enveloop/miniMO/README.md

# miniMO
Programmable mini Synthesizer Module </br>

https://minimosynth.com/

we've got a forum! 

https://www.minimosynth.com/forum/
