enveloop/miniMO/BOM_and_schematic/miniMO_schematic.png

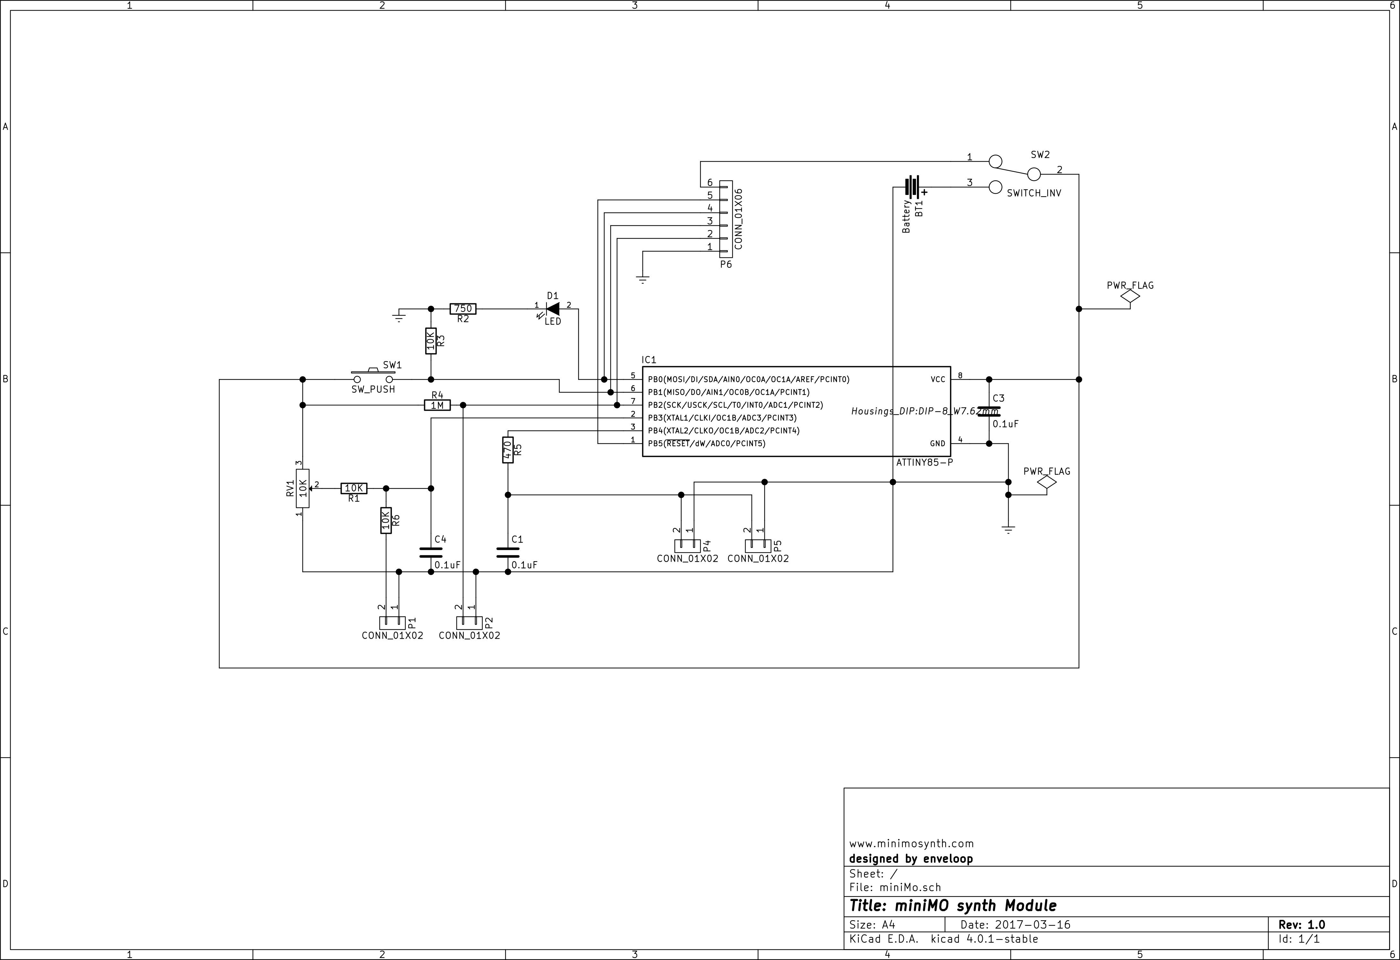
BOM_and_schematic/miniMO_schematic.png
