enveloop/miniMO/3D_parts/3Dprinted_model/parts_description.txt

3D Printed Model

	/Structure

		In order of assembly (bottom to top):
 		
		*battery_holder
		*battery_lid
		*breadboard_holder
		*breadboard
		*ports_holder
		*top
		*shaft neck
		
		Settings: 
			All parts Rigid filament (PLA), layer height 0.3 mm, default speed 40 mm/s
			Head diameter 0.40 EXCEPT for the breadboard, which needs a 0.25 or less
			
	/Covers

		*down_cover
		*up_cover

			Settings: same as above
