enveloop/miniMO/3D_parts/3Dprinted_model/miniMO_3Dprint.jpg

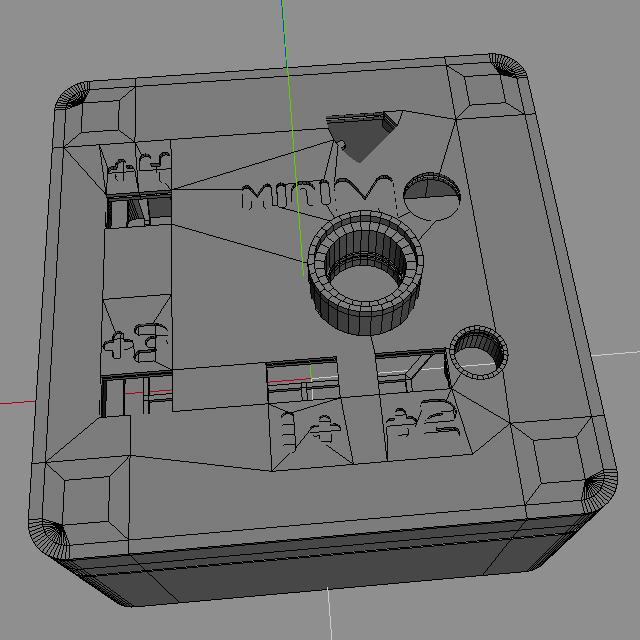
3D_parts/3Dprinted_model/miniMO_3Dprint.jpg
