enveloop/miniMO/3D_parts/3Dprinted_model/miniMO_3Dprint_exploded.jpg

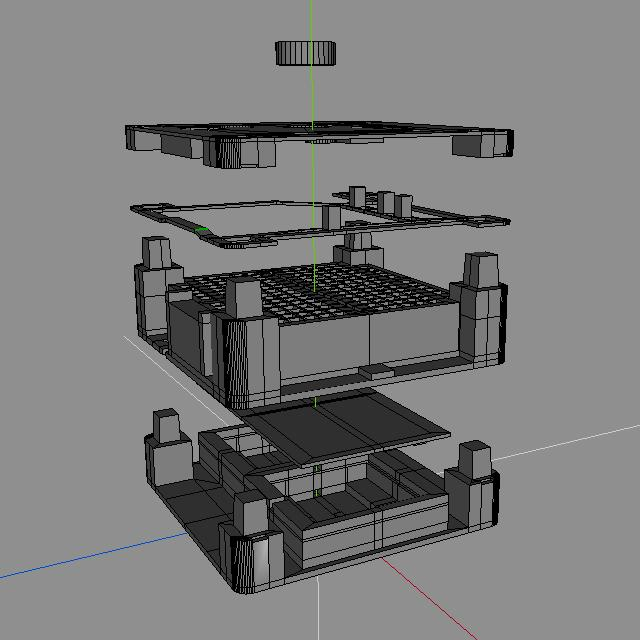
3D_parts/3Dprinted_model/miniMO_3Dprint_exploded.jpg
