enveloop/miniMO/BOM_and_schematic/Gerber_panel_2x2/minimo_Combined_Bottom.png

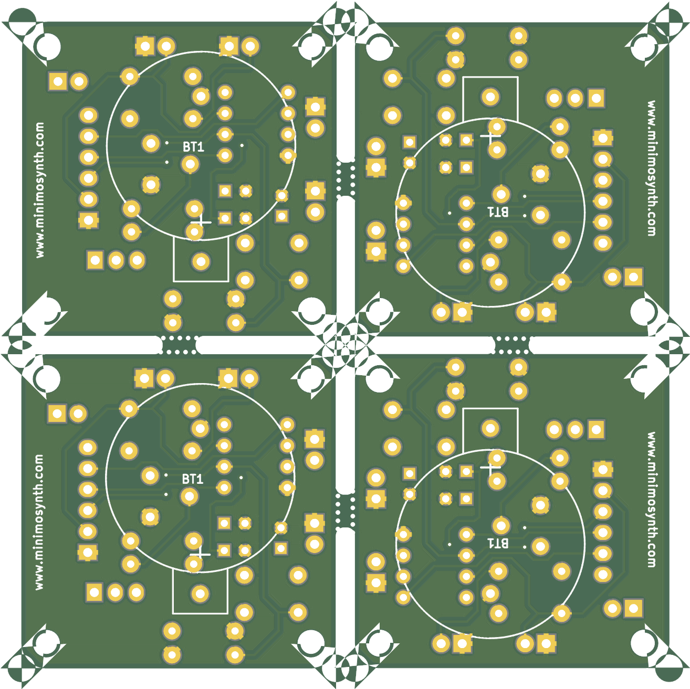
BOM_and_schematic/Gerber_panel_2x2/minimo_Combined_Bottom.png
