enveloop/miniMO/3D_parts/3Dprinted_model/Covers/down_cover.stl

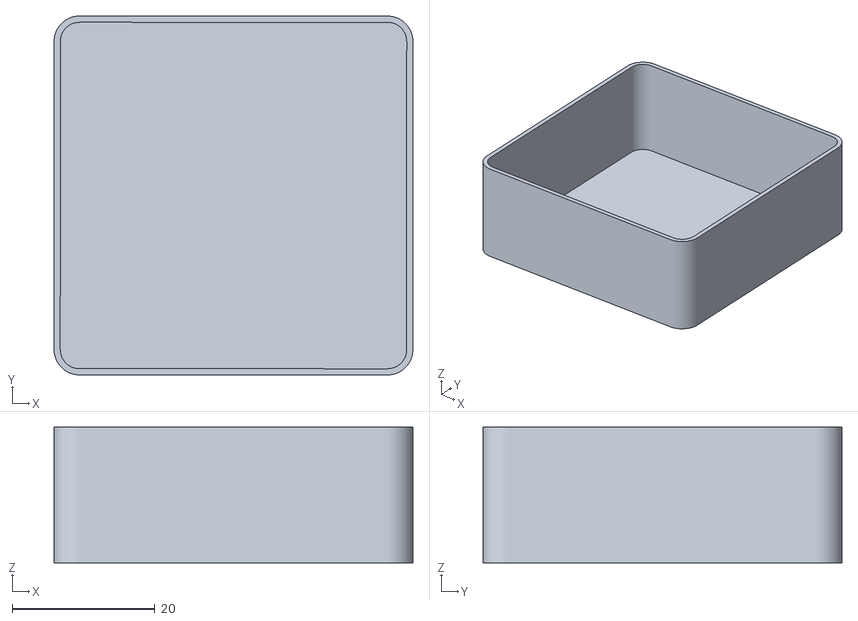
[picture p6: CAD file, 2017-03-13]
3D_parts/3Dprinted_model/Covers/down_cover.stl
50.3 x 50.3 x 19.0
