enveloop/miniMO/3D_parts/PCB_model/Case/Bases/for_flexible_cover/2_part_case_up_base_for_flexible_cover.stl

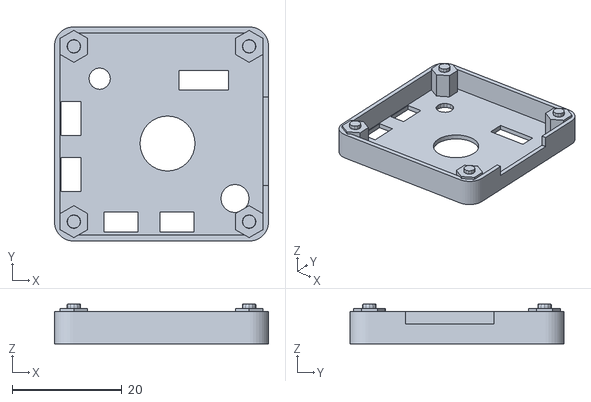
[picture p8: CAD file, 2016-07-05]
3D_parts/PCB_model/Case/Bases/for_flexible_cover/2_part_case_up_base_for_flexible_cover.stl
38.9 x 39.0 x 7.20
