enveloop/miniMO/3D_parts/PCB_model/Case/Bases/for_rigid_cover/2_part_case_up_base.stl

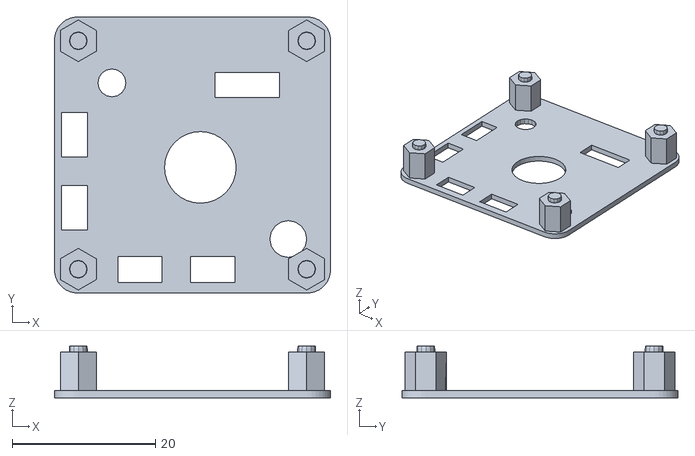
[picture p9: CAD file, 2016-07-05]
3D_parts/PCB_model/Case/Bases/for_rigid_cover/2_part_case_up_base.stl
38.6 x 38.6 x 7.20
