enveloop/miniMO/3D_parts/PCB_model/Case/Covers/2_part_case_up_cover.stl

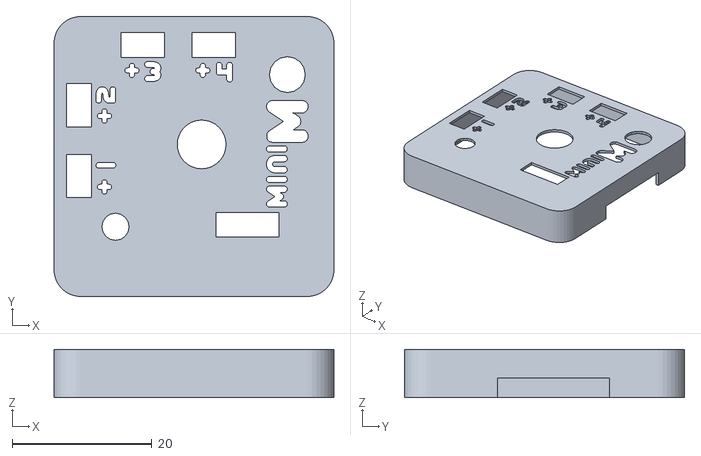
[picture p10: CAD file, 2016-07-05]
3D_parts/PCB_model/Case/Covers/2_part_case_up_cover.stl
40.1 x 40.1 x 6.90
