enveloop/miniMO/3D_parts/PCB_model/Connectors_and_Legs/hex_legs_stabilizer.stl

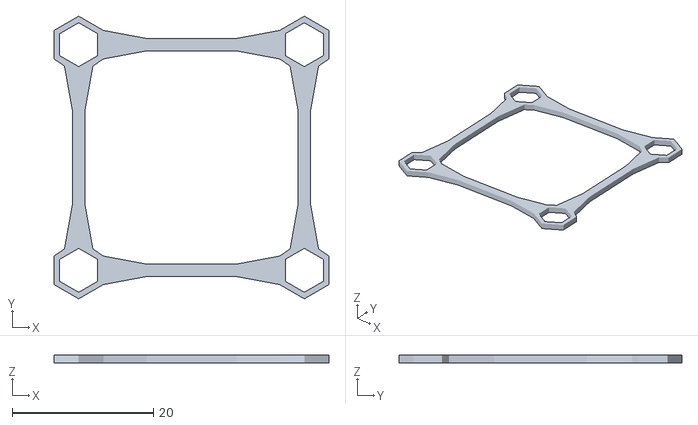
[picture p11: CAD file, 2016-04-10]
3D_parts/PCB_model/Connectors_and_Legs/hex_legs_stabilizer.stl
38.9 x 40.0 x 1.09
