enveloop/miniMO/3D_parts/PCB_model/Tools/circuit_placement_jig.stl

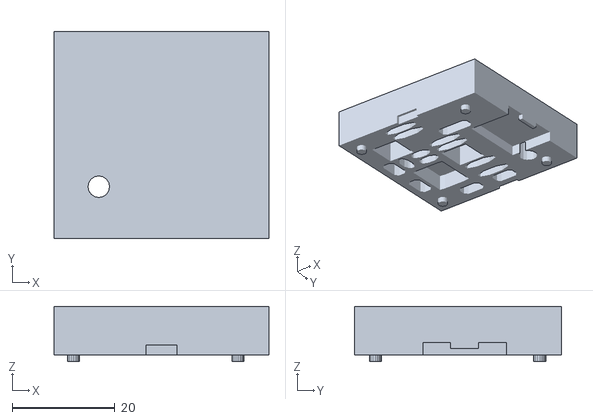
[picture p12: CAD file, 2019-10-22]
3D_parts/PCB_model/Tools/circuit_placement_jig.stl
41.9 x 40.4 x 10.7
