enveloop/miniMO/3D_parts/3Dprinted_model/Covers/up_cover.stl

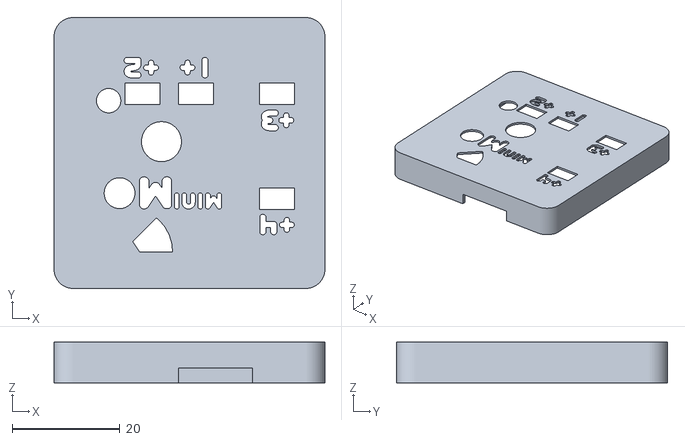
[picture p13: CAD file, 2017-03-13]
3D_parts/3Dprinted_model/Covers/up_cover.stl
50.3 x 50.3 x 7.54
