enveloop/miniMO/3D_parts/3Dprinted_model/Structure/top.stl

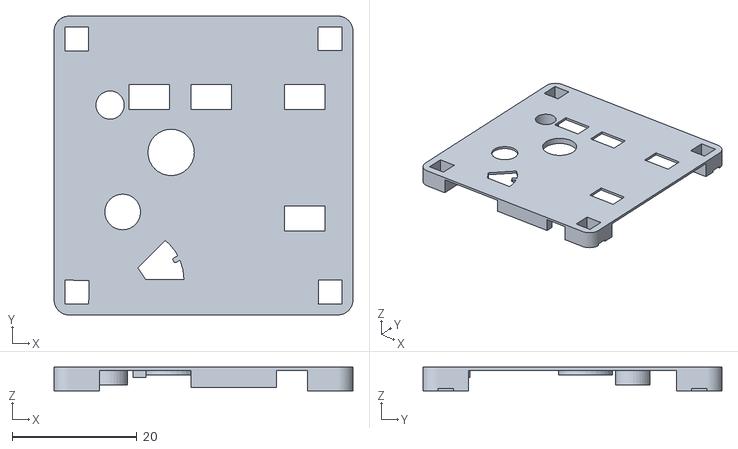
[picture p14: CAD file, 2017-03-13]
3D_parts/3Dprinted_model/Structure/top.stl
48.0 x 48.0 x 3.80
