enveloop/miniMO/3D_parts/PCB_model/Case/Bases/for_flexible_cover/2_part_case_down_base_for_flexible_cover.stl

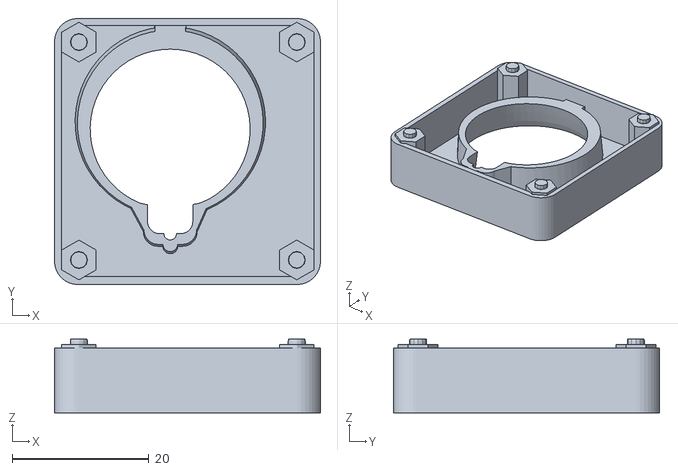
[picture p15: CAD file, 2016-07-05]
3D_parts/PCB_model/Case/Bases/for_flexible_cover/2_part_case_down_base_for_flexible_cover.stl
38.9 x 38.9 x 10.8
