enveloop/miniMO/3D_parts/PCB_model/Case/Bases/for_rigid_cover/2_part_case_down_base.stl

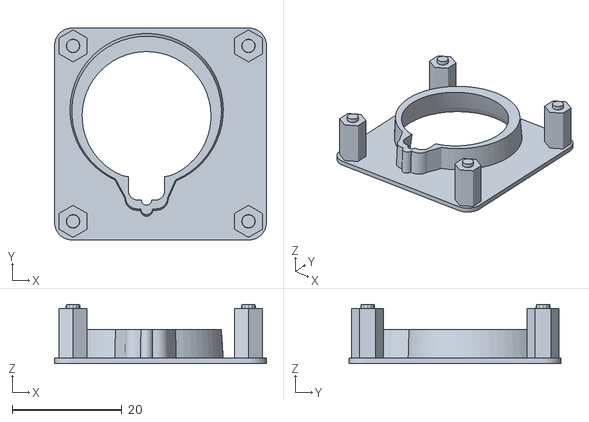
[picture p16: CAD file, 2016-07-05]
3D_parts/PCB_model/Case/Bases/for_rigid_cover/2_part_case_down_base.stl
38.6 x 38.6 x 10.8
