enveloop/miniMO/3D_parts/PCB_model/Connectors_and_Legs/hex_connector_b.stl

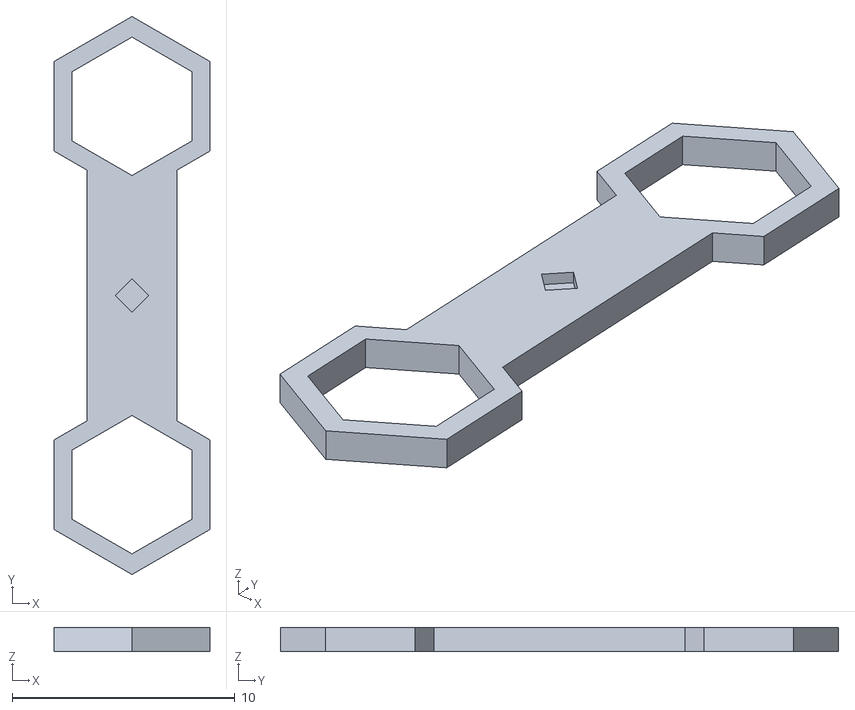
[picture p18: CAD file, 2016-04-10]
3D_parts/PCB_model/Connectors_and_Legs/hex_connector_b.stl
6.98 x 25.0 x 1.09
