enveloop/miniMO/3D_parts/PCB_model/Tools/resistor_bend_tool.stl

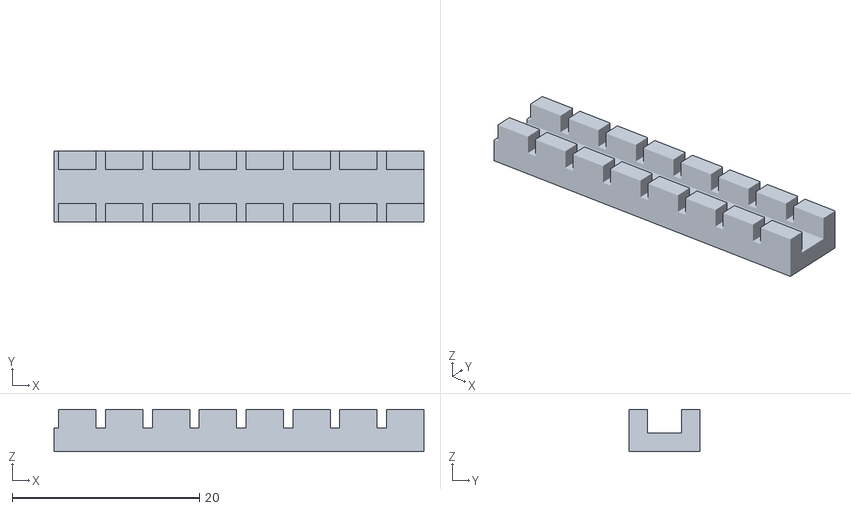
[picture p19: CAD file, 2019-10-22]
3D_parts/PCB_model/Tools/resistor_bend_tool.stl
39.5 x 7.60 x 4.50
