enveloop/miniMO/3D_parts/3Dprinted_model/Structure/breadboard.stl

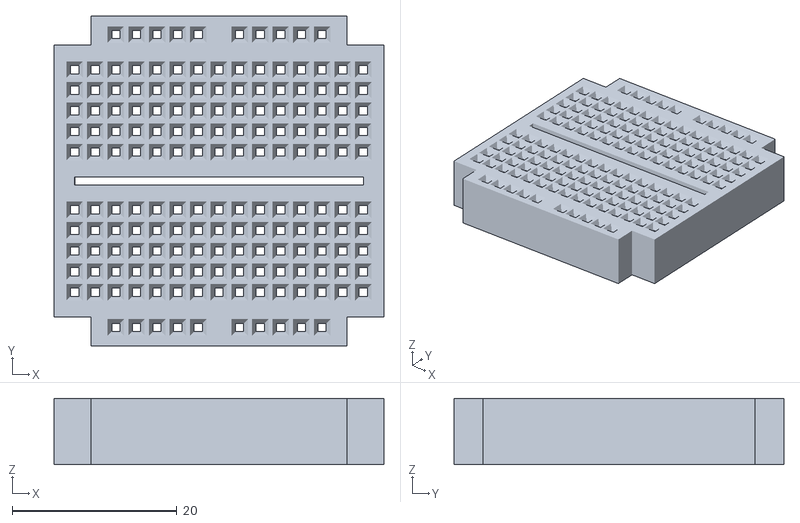
[picture p20: CAD file, 2017-03-13]
3D_parts/3Dprinted_model/Structure/breadboard.stl
40.0 x 40.0 x 8.00
