enveloop/miniMO/3D_parts/PCB_model/Connectors_and_Legs/hex_leg_10mm.stl

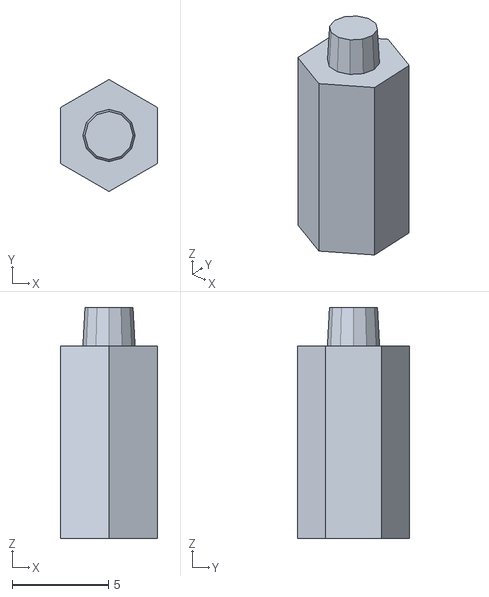
[picture p21: CAD file, 2016-03-29]
3D_parts/PCB_model/Connectors_and_Legs/hex_leg_10mm.stl
5.04 x 5.82 x 12.0
