enveloop/miniMO/3D_parts/3Dprinted_model/Structure/shaft_neck.stl

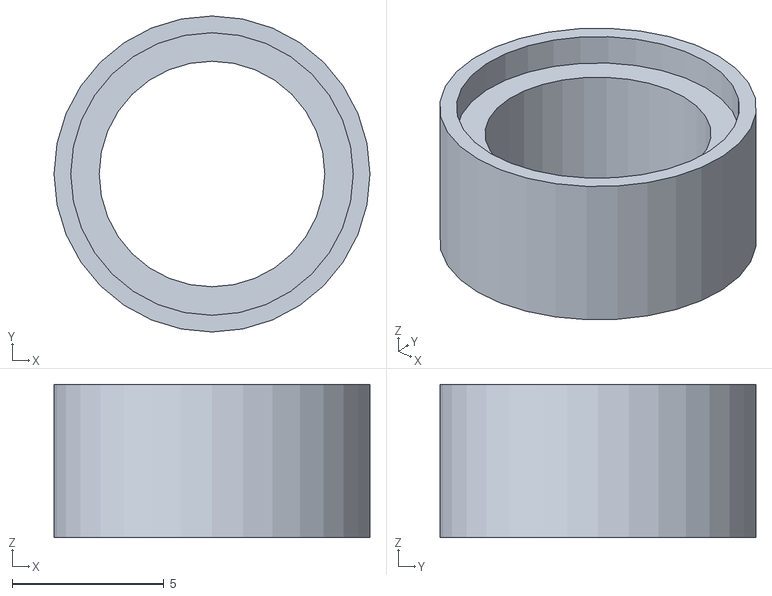
[picture p22: CAD file, 2017-03-13]
3D_parts/3Dprinted_model/Structure/shaft_neck.stl
10.4 x 10.4 x 5.05
