enveloop/miniMO/3D_parts/PCB_model/Connectors_and_Legs/hex_connector.stl

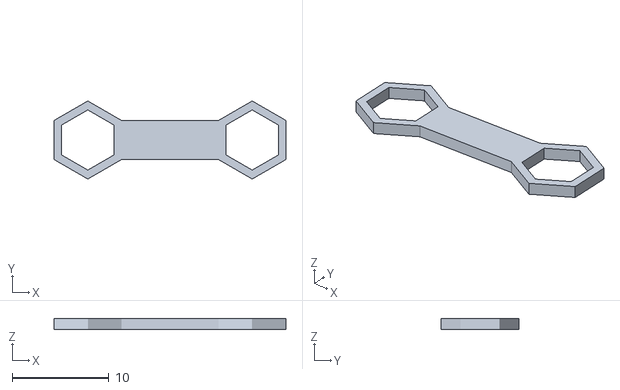
[picture p23: CAD file, 2016-03-23]
3D_parts/PCB_model/Connectors_and_Legs/hex_connector.stl
24.0 x 8.06 x 1.09
