enveloop/miniMO/3D_parts/3Dprinted_model/Structure/breadboard_holder.stl

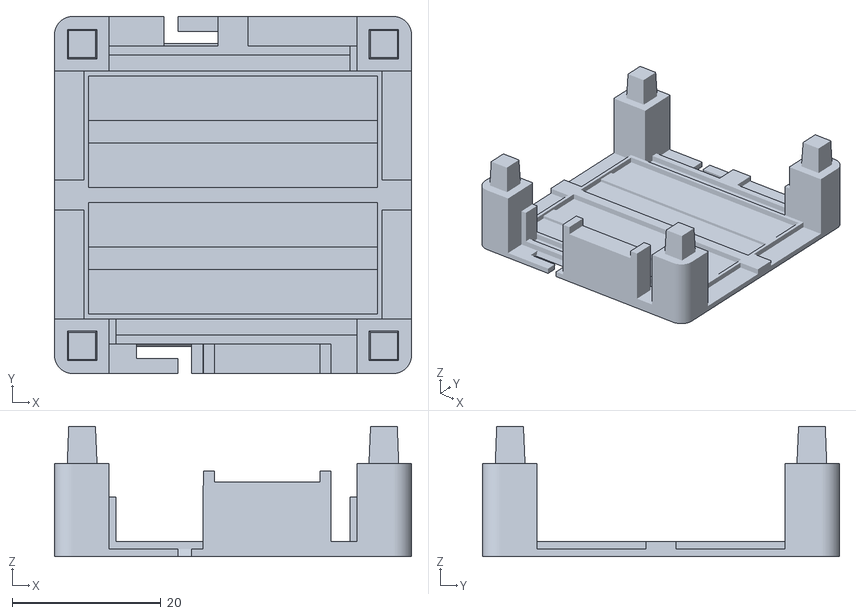
[picture p25: CAD file, 2017-03-13]
3D_parts/3Dprinted_model/Structure/breadboard_holder.stl
48.0 x 48.0 x 17.5
