enveloop/miniMO/3D_parts/3Dprinted_model/Structure/battery_lid.stl

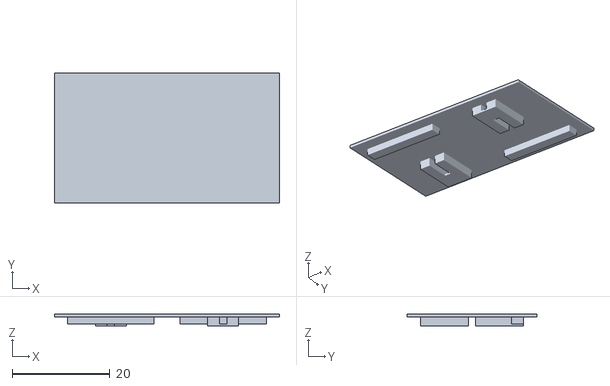
[picture p26: CAD file, 2017-03-13]
3D_parts/3Dprinted_model/Structure/battery_lid.stl
46.0 x 26.5 x 2.50
