enveloop/miniMO/(threads)

Thread 1 (2017-09-29):

not compiling (Windows 7, Arduino 1.6.4

jkervinen, 2017-09-29:
Arduino: 1.6.4 (Windows 7), Board: "ATtiny25/45/85, ATtiny85, Internal 8 MHz"

C:\Users\jukka\AppData\Local\Temp\build2721530541697366340.tmp/core.a(wiring.c.o): In function `__vector_5':
C:\Program Files (x86)\Arduino\hardware\arduino\avr\cores\arduino/wiring.c:49: multiple definition of `__vector_5'
LunaMod.cpp.o:C:\Program Files (x86)\Arduino/LunaMod.ino:111: first defined here
collect2.exe: error: ld returned 1 exit status
Error compiling.

  This report would have more information with
  "Show verbose output during compilation"
  enabled in File > Preferences.

enveloop, 2017-09-29:
I think the issue is related to your arduino IDE version, which is 1.6.4. I'm currently supporting IDE 1.5.7, as explained here:
[http://minimosynth.com/how_to_program_minimo/](http://minimosynth.com/how_to_program_minimo/)
Please try compiling with 1.5.7, and let me know if you still have issues.

jkervinen, 2017-09-29:
OK, thanks of quick reply ! I uninstalled 1.6.4 and installed 1.5.7 back, had already tried with it, compiled without problems, but wasn't able to upload to Minimo. Not sure if 1.6.4 left some extra USB driver, as now it worked, both compiling and uploading.

enveloop, 2017-10-02:
Nice to know that you got it to work! :D

Closed 2017-10-02.

Thread 3 (2017-10-14):

questions about output pins

leobrowning92, 2017-10-14:
Is there a reason that you have made 2 output headers?

also, do you have plans for/ have you considered a design using mono jacks instead of pin headers? On the one hand it might make it more accessible as people can use their existing mono/aux to interface but i guess it might drive price up.

Cheers

enveloop, 2017-10-15:
//Is there a reason that you have made 2 output headers?

Yes, actually several: (for the sake of clarification, we're talking about headers 1 and 2)
*I can check a module's output without disconnecting it from whatever it is modulating;
*I can modulate two things at once (e.g., ADSR controlling both OSC and Filter)
*I like the symmetry with the I/O 3 and 4;
*A free header within this pair doubles as a mixing input. If you are using I/O 1 to listen to module A, you can connect module B's I/O 1 (or 2) to modules A's I/O 2 and also listen to B through A's I/O 1. In fact, you can daisy chain several modules that way. I didn't realize I could do this until recently so I think of it as a hack, but it's actually quite useful :D

// have you considered a design using mono jacks instead of pin headers?

Again, yes -I even built several prototypes using jacks. It is as you say, jacks are more common and everyone has a couple around at home, but the inputs add a lot to a module's cost (compared to the other components); also, jack cables are much more expensive than header wires unless you make them yourself, in which case you might as well use headers and make just the one adapter.

Thanks for your questions!

leobrowning92, 2017-10-15:
the daisy chaining sounds fantastic! I would love to get some more detail as to how it actually can be used for something interesting/useful, as it seems to me that this would only be possible if the output from 1  wouldn't affect the input from 2. Do you have code on the repo that uses them as a mixed input?Id like to have a look.

also small question. it seems like female headers and male header wires is the most common for patch bays etc. was the decision to use male headers again a cost consideration?

Cheers

enveloop, 2017-10-15:
//this would only be possible if the output from 1 wouldn't affect the input from 2
It doesn't, as far as I can tell. Off the top of my head, it's a simple way to combine several oscillators in a single output. See [here](https://twitter.com/miniMOsynth/status/919383247527862272)

//Do you have code on the repo that uses them as a mixed input?
There's no code, this feature is analog xD

//was the decision to use male headers again a cost consideration?

I think male headers are cheaper, yes. Also, I connect the modules with pairs of wires to ensure they always share grounds, and the female wires I have around are easy to glue together and fit securely inside the cases I designed; male wires often have cylindrical ends, so they're hard to manipulate in pairs, and in any case they stick out quite a bit. I built one or two modules with female headers for tests, but I think male headers are a better choice for this particular design.

That said, having the exposed male pins allows you to tap on the inputs with your fingers for some interesting effects, and lately I'm exploiting this "hack" by using I/O4 as a second button  (in [LunaMod](https://github.com/enveloop/miniMO/blob/master/Programs/LunaMod_Generator/LunaMod_Generator.ino) and the [Low Power Beacon](https://github.com/enveloop/miniMO/blob/master/Programs/Low_Power_Beacon/Low_Power_Beacon.ino), at the moment).

leobrowning92, 2017-10-15:
Cool, so perhaps calling them mixed inputs isn't the best way to phrase it, as the attiny cant actually process an input signal through them. Instead they facilitate daisychaining of outputs.

Im getting more and more excited to build some of these so I can get playing! the parts are still in the mail, but ive just designed the PCB to encorporate them. was there a reason you went with 38x38mm square instead of an even 40x40mm?

Cheers again for being so cool about all of my questions!

enveloop, 2017-10-15:
//Cool, so perhaps calling them mixed inputs isn't the best way to phrase it, as the attiny cant actually process an input signal through them.

In the very first version of the board I named 1&2 "OUT", and 3&4 "IN 1-2"; later on I realized that I could use input 2 as an output, so I decided to rename them all to a generic I/O 1-4 and specify what they actually do in the manual at the beginning of every program. I don't think I'll have a program where I use 1-2 as processing inputs, but this way I'm already covered for that eventuality (and a mixing input is still an input, after all!).

//was there a reason you went with 38x38mm square instead of an even 40x40mm?

It's the smallest I could design it :P
Conveniently, if you add an enclosure surrounding the board with walls 1mm thick, you reach 40x40. The female "programming" headers protrude from the board, and that's so that they are flush with the enclosure.

//Cheers again for being so cool about all of my questions!
Thanks for asking! I'm kind of wishing I had a forum, rather than having them under issues, though.

leobrowning92, 2017-10-15:
re forum, a slack/discord/gitter would be easy to implement, and I would be stoked to provide some initial critical mass :)

enveloop, 2017-10-16:
I take your word on that :D I'll give them a look.

Closed 2017-10-21.

Thread 4 (2017-11-23):

fritzing file missing parts

VinuDFrame, 2017-11-23:
I am a first time fritzer, so this may be an issue with the user.

When I try to load the file, the program is unable to find 5 parts.  I will attach a window capture of this.

Thanks!
Prof Frame
Vincennes University
Focused Quality Education
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

enveloop, 2017-11-23:
Hi, thanks for reporting -it looks like the file saved my local paths to the parts. I don't recall having anything custom, so this is a bit odd; I'm no expert with Fritzing either, but I'll see what can I do.

enveloop, 2017-11-23:
Hi again! I don't know why Fritzing saved local paths, but the .fzz is a a zip file, and the .fz, an xml file, so I edited all the paths by hand. The file opens correctly in my computer, so please try opening it now and tell me if it works.

Also, note that the purpose of the file is only to show how to place the components on the breadboard (it's better than a picture because you can move things around), so I didn't do any work on the schematic or the pcb views.

VinuDFrame, 2017-11-28:
Thanks for  your quick attention to this, Jose!

enveloop, 2017-11-28:
you're very much welcome :D

Closed 2017-11-28.
