enveloop/miniMO/(list of files, drawings)

Other design files:
BOM_and_schematic/miniMO_breadboard.fzz
