enveloop/miniMO/Programs/Display_Example/oled.h

/*
//******************************
//*   miniMO OLED_SSD1306      *
//*   2017 by enveloop         *
//******************************
  Adapted from the SSD1306xLED library 
        by Neven Boyanov,
        as described Here:
  https://tinusaur.org/projects/ssd1306xled/
  SCROLL DOWN FOR SSD1306xLED LICENSE

//
   http://www.minimosynth.com/
   CC BY 4.0
   Licensed under a Creative Commons Attribution 4.0 International license: 
   http://creativecommons.org/licenses/by/4.0/
//

*/

#include <avr/pgmspace.h>

#define OLED_h

///////////USER SETTINGS/////////////

#define SCREEN_WIDTH		64
#define SCREEN_HEIGHT		48

#define FLIPSCREEN              0       // 0 or 1         

/////////////////////////////////////

#define SCL		        PB0	// SCL,	MO in miniMO
#define SDA		        PB2	// SDA,	SCK in miniMO (you lose I/O 4)
//#define SDA		        PB1	// SDA,	MI in miniMO (you lose push button)  

#define SA		        0x78	// Slave address

class OLED 
{
  public:
    void init(void);
    void initB(void);
    void fillscreen(unsigned int fill_Data);
    void fillLine(unsigned int line, unsigned int fill_Data);
    void char_f6x8(uint8_t x, uint8_t y, const char ch[]);
    
  private:
    void xfer_start(void);
    void xfer_stop(void);
    void send_byte(uint8_t byte); 
    void send_command(uint8_t command);
    void send_data_start(void);
    void send_data_stop(void);
    void setpos(unsigned int x, unsigned int y);
};

/* Standard ASCII 6x8 font */
const uint8_t font6x8 [] PROGMEM = 
{
  0x00, 0x00, 0x00, 0x00, 0x00, 0x00, // sp
  0x00, 0x00, 0x00, 0x2f, 0x00, 0x00, // !
  0x00, 0x00, 0x07, 0x00, 0x07, 0x00, // "
  0x00, 0x14, 0x7f, 0x14, 0x7f, 0x14, // #
  0x00, 0x24, 0x2a, 0x7f, 0x2a, 0x12, // $
  0x00, 0x62, 0x64, 0x08, 0x13, 0x23, // %
  0x00, 0x36, 0x49, 0x55, 0x22, 0x50, // &
  0x00, 0x00, 0x05, 0x03, 0x00, 0x00, // '
  0x00, 0x00, 0x1c, 0x22, 0x41, 0x00, // (
  0x00, 0x00, 0x41, 0x22, 0x1c, 0x00, // )
  0x00, 0x14, 0x08, 0x3E, 0x08, 0x14, // *
  0x00, 0x08, 0x08, 0x3E, 0x08, 0x08, // +
  0x00, 0x00, 0x00, 0xA0, 0x60, 0x00, // ,
  0x00, 0x08, 0x08, 0x08, 0x08, 0x08, // -
  0x00, 0x00, 0x60, 0x60, 0x00, 0x00, // .
  0x00, 0x20, 0x10, 0x08, 0x04, 0x02, // /
  0x00, 0x3E, 0x51, 0x49, 0x45, 0x3E, // 0
  0x00, 0x00, 0x42, 0x7F, 0x40, 0x00, // 1
  0x00, 0x42, 0x61, 0x51, 0x49, 0x46, // 2
  0x00, 0x21, 0x41, 0x45, 0x4B, 0x31, // 3
  0x00, 0x18, 0x14, 0x12, 0x7F, 0x10, // 4
  0x00, 0x27, 0x45, 0x45, 0x45, 0x39, // 5
  0x00, 0x3C, 0x4A, 0x49, 0x49, 0x30, // 6
  0x00, 0x01, 0x71, 0x09, 0x05, 0x03, // 7
  0x00, 0x36, 0x49, 0x49, 0x49, 0x36, // 8
  0x00, 0x06, 0x49, 0x49, 0x29, 0x1E, // 9
  0x00, 0x00, 0x36, 0x36, 0x00, 0x00, // :
  0x00, 0x00, 0x56, 0x36, 0x00, 0x00, // ;
  0x00, 0x08, 0x14, 0x22, 0x41, 0x00, // <
  0x00, 0x14, 0x14, 0x14, 0x14, 0x14, // =
  0x00, 0x00, 0x41, 0x22, 0x14, 0x08, // >
  0x00, 0x02, 0x01, 0x51, 0x09, 0x06, // ?
  0x00, 0x32, 0x49, 0x59, 0x51, 0x3E, // @
  0x00, 0x7C, 0x12, 0x11, 0x12, 0x7C, // A
  0x00, 0x7F, 0x49, 0x49, 0x49, 0x36, // B
  0x00, 0x3E, 0x41, 0x41, 0x41, 0x22, // C
  0x00, 0x7F, 0x41, 0x41, 0x22, 0x1C, // D
  0x00, 0x7F, 0x49, 0x49, 0x49, 0x41, // E
  0x00, 0x7F, 0x09, 0x09, 0x09, 0x01, // F
  0x00, 0x3E, 0x41, 0x49, 0x49, 0x7A, // G
  0x00, 0x7F, 0x08, 0x08, 0x08, 0x7F, // H
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
  0x14, 0x14, 0x14, 0x14, 0x14, 0x14, // horiz lines
};

/*
//SSD1306xLED LICENSE//
Copyright (c) 2016 Neven Boyanov, Tinusaur Team. All Rights Reserved.

Permission is hereby granted, free of charge, to any person obtaining a copy 
of this software and associated documentation files (the "Software"), to deal 
in the Software without restriction, including without limitation the rights 
to use, copy, modify, merge, publish, distribute, sublicense, and/or sell 
copies of the Software, and to permit persons to whom the Software is 
furnished to do so, subject to the following conditions:

The above copyright notice and this permission notice shall be included 
in all copies or substantial portions of the Software.

THE SOFTWARE IS PROVIDED "AS IS", WITHOUT WARRANTY OF ANY KIND, EXPRESS 
OR IMPLIED, INCLUDING BUT NOT LIMITED TO THE WARRANTIES OF MERCHANTABILITY, 
FITNESS FOR A PARTICULAR PURPOSE AND NONINFRINGEMENT. IN NO EVENT SHALL THE 
AUTHORS OR COPYRIGHT HOLDERS BE LIABLE FOR ANY CLAIM, DAMAGES OR OTHER 
LIABILITY, WHETHER IN AN ACTION OF CONTRACT, TORT OR OTHERWISE, ARISING FROM, 
OUT OF OR IN CONNECTION WITH THE SOFTWARE OR THE USE OR OTHER DEALINGS IN 
THE SOFTWARE.
*/
