enveloop/miniMO/(commit log)

2016-02-29 Changed interrupt from COMPA to OVF Changed operation when switching between parameters: -When returning to controlling a parameter, miniMO won't do anything until the potentiometer reaches the point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
    [DCO.ino]
2016-03-04 -Added voltage check on power-up -Added freq input calibration procedure(for external inputs) -Revised manual
2016-03-12 -New: Calibration values are saved to EEPROM after calibration, and recalled on power up. -New: If the max calibration value is 0 (never saved to memory before), make it 1023 (default max value with 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
    [DCO.ino]
2016-03-12 -Bug Fix: can't calibrate the osc with a sequencer connected if I have just turned the osc on (solution: allow frequency change on power up)
    [DCO.ino]
2016-03-14 corrected information on the clock setup
    [Tuned_Controller.ino]
2016-03-16 *declared frequency as volatile *disabled USI to save power
2016-03-16 disabled usi to save power
2016-03-23 added hex connector, updated documents
    [hex_connector.stl]
2016-03-29 added hexagonal leg, revised parts description
    [hex_leg_10mm.stl]
2016-03-29 added default printing settings
2016-03-29 revised model for better fit
    [hex_leg_10mm.stl]
2016-04-10 added legs stabilizer ring to lock the rotations added new connector with the hexes rotated by 90 degrees
    [hex_connector_b.stl, hex_legs_stabilizer.stl]
2016-05-26 Clarified calibration instructions
2016-05-26 Revising folder structure in preparation for new parts
    [hex_connector.stl, hex_connector_b.stl, hex_leg_10mm.stl, hex_legs_stabilizer.stl]
2016-05-26 removing copied files
    [hex_connector.stl, hex_connector_b.stl, hex_leg_10mm.stl, hex_legs_stabilizer.stl]
2016-06-11 Clarified calibration instructions; added a troubleshooting guide
2016-06-11 -Added troubleshooting to calibration documentation -Revised which digital inputs were disabled -Changed frequency variable to unsigned
2016-06-11 -Clarified documentation -Added calibration troubleshooting -Revised pin disabling -Changed array length number for the variable name
2016-06-12 -Improved calibration instructions -Fixed bug whereby the random step generator sometimes produced a step out of range
    [Sequencer.ino]
2016-07-05 Added 3d models for the case
    [2_part_case_down_scaffolding.stl, 2_part_case_down_scaffolding_for_filaflex.stl, 2_part_case_down_shell.stl, 2_part_case_down_shell_in_filaflex.stl, 2_part_case_up_scaffolding.stl, 2_part_case_up_scaffolding_for_filaflex.stl, 2_part_case_up_shell.stl, 2_part_case_up_shell_in_filaflex.stl]
2016-07-28 deleted unused parts
    [2_part_case_down_shell_in_filaflex.stl, 2_part_case_up_shell_in_filaflex.stl]
2016-07-28 deleted old folder structure
    [2_part_case_down_scaffolding.stl, 2_part_case_down_scaffolding_for_filaflex.stl, 2_part_case_down_shell.stl, 2_part_case_up_scaffolding.stl, 2_part_case_up_scaffolding_for_filaflex.stl, 2_part_case_up_shell.stl]
2016-07-28 added revised case files
    [2_part_case_down_base.stl, 2_part_case_down_base_for_flexible_cover.stl, 2_part_case_down_cover.stl, 2_part_case_up_base.stl, 2_part_case_up_base_for_flexible_cover.stl, 2_part_case_up_cover.stl]
2016-11-08 errata: self-oscillate, rather than resonate
    [LPF.ino]
2016-11-14 improving feedback through led blinks
2017-03-13 added folder for the 3dprinted model, and moved the parts for the PCB model to a new folder
    [2_part_case_down_base.stl, 2_part_case_down_base_for_flexible_cover.stl, 2_part_case_down_cover.stl, 2_part_case_up_base.stl, 2_part_case_up_base_for_flexible_cover.stl, 2_part_case_up_cover.stl, hex_connector.stl, hex_connector_b.stl]
2017-03-13 deleted moved files
    [2_part_case_down_base.stl, 2_part_case_down_base_for_flexible_cover.stl, 2_part_case_down_cover.stl, 2_part_case_up_base.stl, 2_part_case_up_base_for_flexible_cover.stl, 2_part_case_up_cover.stl, hex_connector.stl, hex_connector_b.stl]
2017-03-13 moved pcb model parts description
2017-03-13 added stls
    [battery_holder.stl, battery_lid.stl, breadboard.stl, breadboard_holder.stl, down_cover.stl, ports_holder.stl, shaft_neck.stl, top.stl]
2017-03-16 added BOM and schematic
    [miniMO_breadboard.fzz]
2017-03-16 added gerber files
    [miniMO-B.Cu.gbl, miniMO-B.Mask.gbs, miniMO-B.SilkS.gbo, miniMO-Edge.Cuts.gm1, miniMO-F.Cu.gtl, miniMO-F.Mask.gts, miniMO-F.SilkS.gto, miniMO.drl]
2017-03-19 updated to latest revision of the guide
    [miniMO_breadboard.fzz]
2017-03-27 fixed typo in comments
    [DCO.ino]
2017-03-28 explicitly set the voltage reference for battery check
2017-03-29 revised battery code
2017-03-29 revised ADC settings
2017-03-30 corrected a comment referencing the wrong timer removed unnecessary start conversion instruction
    [LPF.ino]
2017-03-31 removed cbi shorthand (I realized I was not using it anymore)
    [LPF.ino]
2017-03-31 removing shorthands for ADCs. Reason why:
    define adc1 ((1<<ADLAR) | 1)
    define adc3 ((1<<ADLAR) | 3)
    ADMUX = adc1 is neat, but implicitly resets the three REFS to 0. If I wanted to have a voltage reference other than Vcc, I would have to write
    define adc1 ((1<<REFS2) |(1<<REFS1) |(1<<ADLAR) | 1)
    define adc3 ((1<<REFS2) |(1<<REFS1) |(1<<ADLAR) | 3)
    , and if I wanted to change the voltage reference, I'd have to do it in both places, instead of only once in setup, which is where I would look for it. Also, this sets ADLAR, which is great unless I wanted to try 10 bits ADC. Also, | 1 and | 3 look very neat but they are confusing, until one reads the datasheet and realizes that (1<<MUX1)| (1<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
    [LPF.ino]
2017-04-04 reading button input directly rather than through digitalRead
2017-04-04 reading button input directly rather than through digitalRead revised for style consistency with other programs
2017-04-06 reading button input directly rather than through digitalRead using cli() and sei() to disable and enable global interrupts
2017-04-06 using cli() and sei() to disable and enable global interrupts
2017-04-06 clarification in calibration procedure
2017-04-06 using cli() and sei() to disable and enable global interrupts clarification on hex value revised for consistency with other programs
2017-04-06 revised manual reading button input directly rather than through digitalRead using cli() and sei() to disable and enable global interrupts clarification on hex values revised for consistency with oth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
2017-05-02 fixed: missing one value in sinewave generation
    [DCO.ino]
2017-06-01 fixed typo in description
    [Low_Power_Beacon.ino]
2017-08-30 Fix: LED blinks 3 times after a long press
    [Amplitude_Modulation_Generator.ino]
2017-10-16 fixed: for loop was not reaching the last note
    [LunaMod_Generator.ino]
2017-10-29 *minor bug:memory address was using a fixed value *improved comments on initSteps()
    [Sequencer.ino]
2017-11-04 revised manual, fixed wrong reference to pin in setup comments
    [Sequencer.ino]
2017-11-05 fixed a bug that caused a bump in volume under certain conditions improved handling and revised for typos
    [ADSR.ino]
2017-11-06 revised the comments on pin input interrupt
2017-11-22 added MIDI out cable specs
2017-11-23 fixed references to local files
    [miniMO_breadboard.fzz]
2018-03-26 reimporting program (the IDE doesn't like programs starting with numbers)
    [Tone12_MIDI.ino]
2018-05-08 *fixed a typo in the help section *removed unused code
    [Noise_Generator.ino]
2018-05-09 added xorshift noise as one of the examples
    [Algorithmic_Generator.ino]
2018-05-13 added noise random generator - generates random noise but the noise parameters also change to random values
    [Noise_Random_Generator.ino]
2018-09-04 added note on ext trigger voltages
2018-09-14 small correction in the manual
    [Sequencer_MIDI.ino]
2018-09-16 solved bug: tempo control not working added link to AMPLE worksheet added extra clarification about notation small tweak to Bach's piece
    [Chiptune_Player.ino]
2018-09-17 solved issue where the input readings were interfering with one another various other minor tweaks and modifications
    [Chiptune_Player.ino]
2018-09-18 modified configuration to allow for button detection revised manual
2018-09-18 fixed: module wouldn't output sound after a power reset (pin reset was fine) fixed: external triggering would advance to next tune from the middle of a tune which had been set to repeat after it had 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
    [Chiptune_Player.ino]
2018-11-08 corrected a reference to the wrong input in a comment
    [Chiptune_Player.ino]
2019-03-25 initializing parameters to current algorithm on startup (was hardcoded to 0)
2019-05-24 gerber files updated to V1.1 (MI-MO texts in proper order; new website link)
    [miniMO-B.Cu.gbl, miniMO-B.Mask.gbs, miniMO-B.SilkS.gbo, miniMO-Edge.Cuts.gm1, miniMO-F.Cu.gtl, miniMO-F.Mask.gts, miniMO-F.SilkS.gto]
2019-05-26 first panelized version
    [combined.drl, combined.gbl, combined.gbo, combined.gbs, combined.gko, combined.gtl, combined.gto, combined.gts]
2019-10-22 Uploaded useful 3Dprinted tools for soldering the PCB
    [circuit_placement_jig.stl, resistor_bend_tool.stl]
